Oszimilian/SBIO/(list of files, drawings)

Other design files:
Hardware/Hardware_Sensorplatine/Sensorplatine/Sensorplatine/Sensorplatine.dsn
