Oszimilian/SBIO/Hardware/Archiev/Hardware_Steuerplatine/Gerber/Gerber_Final/SBIO3_Final/SBIO3_003/SBIO3/SBIO3.kicad_pcb

## KiCad design Hardware/Archiev/Hardware_Steuerplatine/Gerber/Gerber_Final/SBIO3_Final/SBIO3_003/SBIO3/SBIO3.kicad_pcb (2021-06-11)

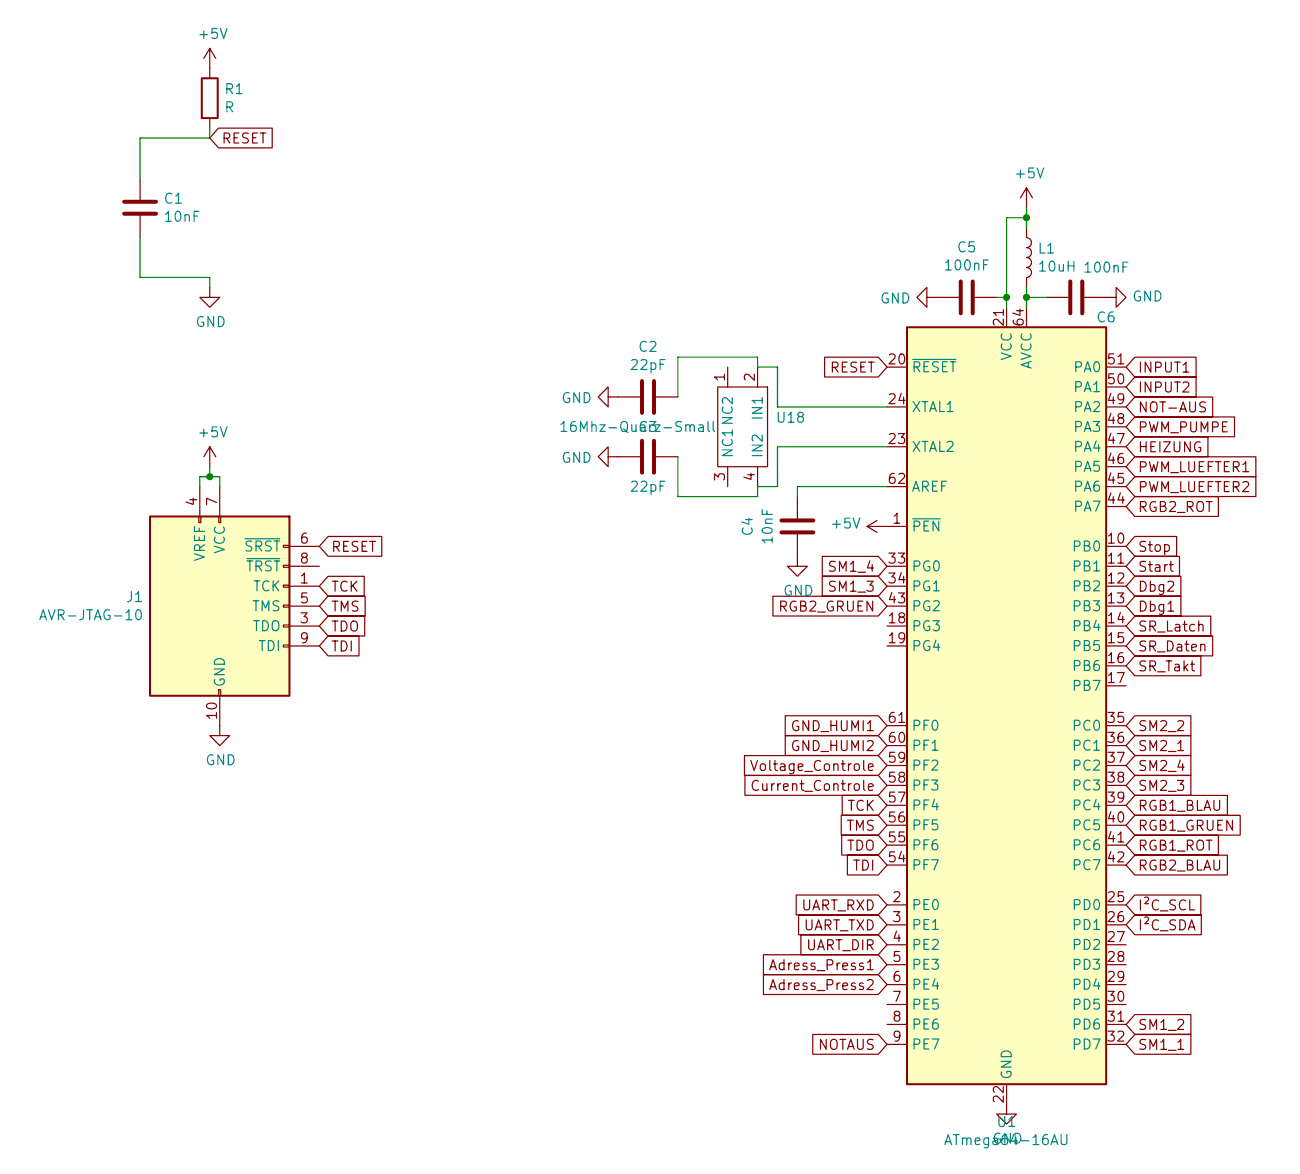
[picture p29: schematic file5EFE1688.sch]

Parts:
C1, C4: 10nF; C_0603_1608Metric_Pad1.05x0.95mm_HandSolder
C2, C3: 22pF; C_0603_1608Metric_Pad1.05x0.95mm_HandSolder
C5, C6: 100nF; C_0603_1608Metric_Pad1.05x0.95mm_HandSolder
J1: AVR-JTAG-10; Wanne-10Pol
L1: 10uH; L_0805_2012Metric_Pad1.15x1.40mm_HandSolder
R1: R; R_0603_1608Metric_Pad1.05x0.95mm_HandSolder
U1: ATmega64-16AU; TQFP-64_14x14mm_P0.8mm
U18: 16Mhz-Quarz-Small; 16Mhz Quarz Small

Connections:
+5V: C5.1, J1.4 (VREF), J1.7 (VCC), L1.1, R1.1, U1.1 (~PEN), U1.21 (VCC), U1.52 (VCC); also elsewhere on the board
Adress_Press1: U1.5 (PE3)
Adress_Press2: U1.6 (PE4); also elsewhere on the board
Current_Controle: U1.58 (PF3); also elsewhere on the board
Dbg1: U1.13 (PB3); also elsewhere on the board
Dbg2: U1.12 (PB2); also elsewhere on the board
GND: C1.2, C2.1, C3.1, C4.1, C5.2, C6.1, J1.2 (GND), J1.10 (GND), U1.22 (GND), U1.53 (GND), U1.63 (GND); also elsewhere on the board
GND_HUMI1: U1.61 (PF0); also elsewhere on the board
GND_HUMI2: U1.60 (PF1); also elsewhere on the board
HEIZUNG: U1.47 (PA4); also elsewhere on the board
INPUT1: U1.51 (PA0); also elsewhere on the board
INPUT2: U1.50 (PA1); also elsewhere on the board
I²C_SCL: U1.25 (PD0); also elsewhere on the board
I²C_SDA: U1.26 (PD1); also elsewhere on the board
NOT-AUS: U1.49 (PA2); also elsewhere on the board
NOTAUS: U1.9 (PE7); also elsewhere on the board
unnamed: C2.2, U1.24 (XTAL1), U18.2 (IN1)
unnamed: C3.2, U1.23 (XTAL2), U18.4 (IN2)
unnamed: C4.2, U1.62 (AREF)
unnamed: C6.2, L1.2, U1.64 (AVCC)
PWM_LUEFTER1: U1.46 (PA5); also elsewhere on the board
PWM_LUEFTER2: U1.45 (PA6); also elsewhere on the board
PWM_PUMPE: U1.48 (PA3); also elsewhere on the board
RESET: C1.1, J1.6 (~SRST), R1.2, U1.20 (~RESET); also elsewhere on the board
RGB1_BLAU: U1.39 (PC4); also elsewhere on the board
RGB1_GRUEN: U1.40 (PC5); also elsewhere on the board
RGB1_ROT: U1.41 (PC6); also elsewhere on the board
RGB2_BLAU: U1.42 (PC7); also elsewhere on the board
RGB2_GRUEN: U1.43 (PG2); also elsewhere on the board
RGB2_ROT: U1.44 (PA7); also elsewhere on the board
SM1_1: U1.32 (PD7); also elsewhere on the board
SM1_2: U1.31 (PD6); also elsewhere on the board
SM1_3: U1.34 (PG1); also elsewhere on the board
SM1_4: U1.33 (PG0); also elsewhere on the board
SM2_1: U1.36 (PC1); also elsewhere on the board
SM2_2: U1.35 (PC0); also elsewhere on the board
SM2_3: U1.38 (PC3); also elsewhere on the board
SM2_4: U1.37 (PC2); also elsewhere on the board
SR_Daten: U1.15 (PB5); also elsewhere on the board
SR_Latch: U1.14 (PB4); also elsewhere on the board
SR_Takt: U1.16 (PB6); also elsewhere on the board
Start: U1.11 (PB1); also elsewhere on the board
Stop: U1.10 (PB0); also elsewhere on the board
TCK: J1.1 (TCK), U1.57 (PF4)
TDI: J1.9 (TDI), U1.54 (PF7)
TDO: J1.3 (TDO), U1.55 (PF6)
TMS: J1.5 (TMS), U1.56 (PF5)
UART_DIR: U1.4 (PE2); also elsewhere on the board
UART_RXD: U1.2 (PE0); also elsewhere on the board
UART_TXD: U1.3 (PE1); also elsewhere on the board
Voltage_Controle: U1.59 (PF2); also elsewhere on the board

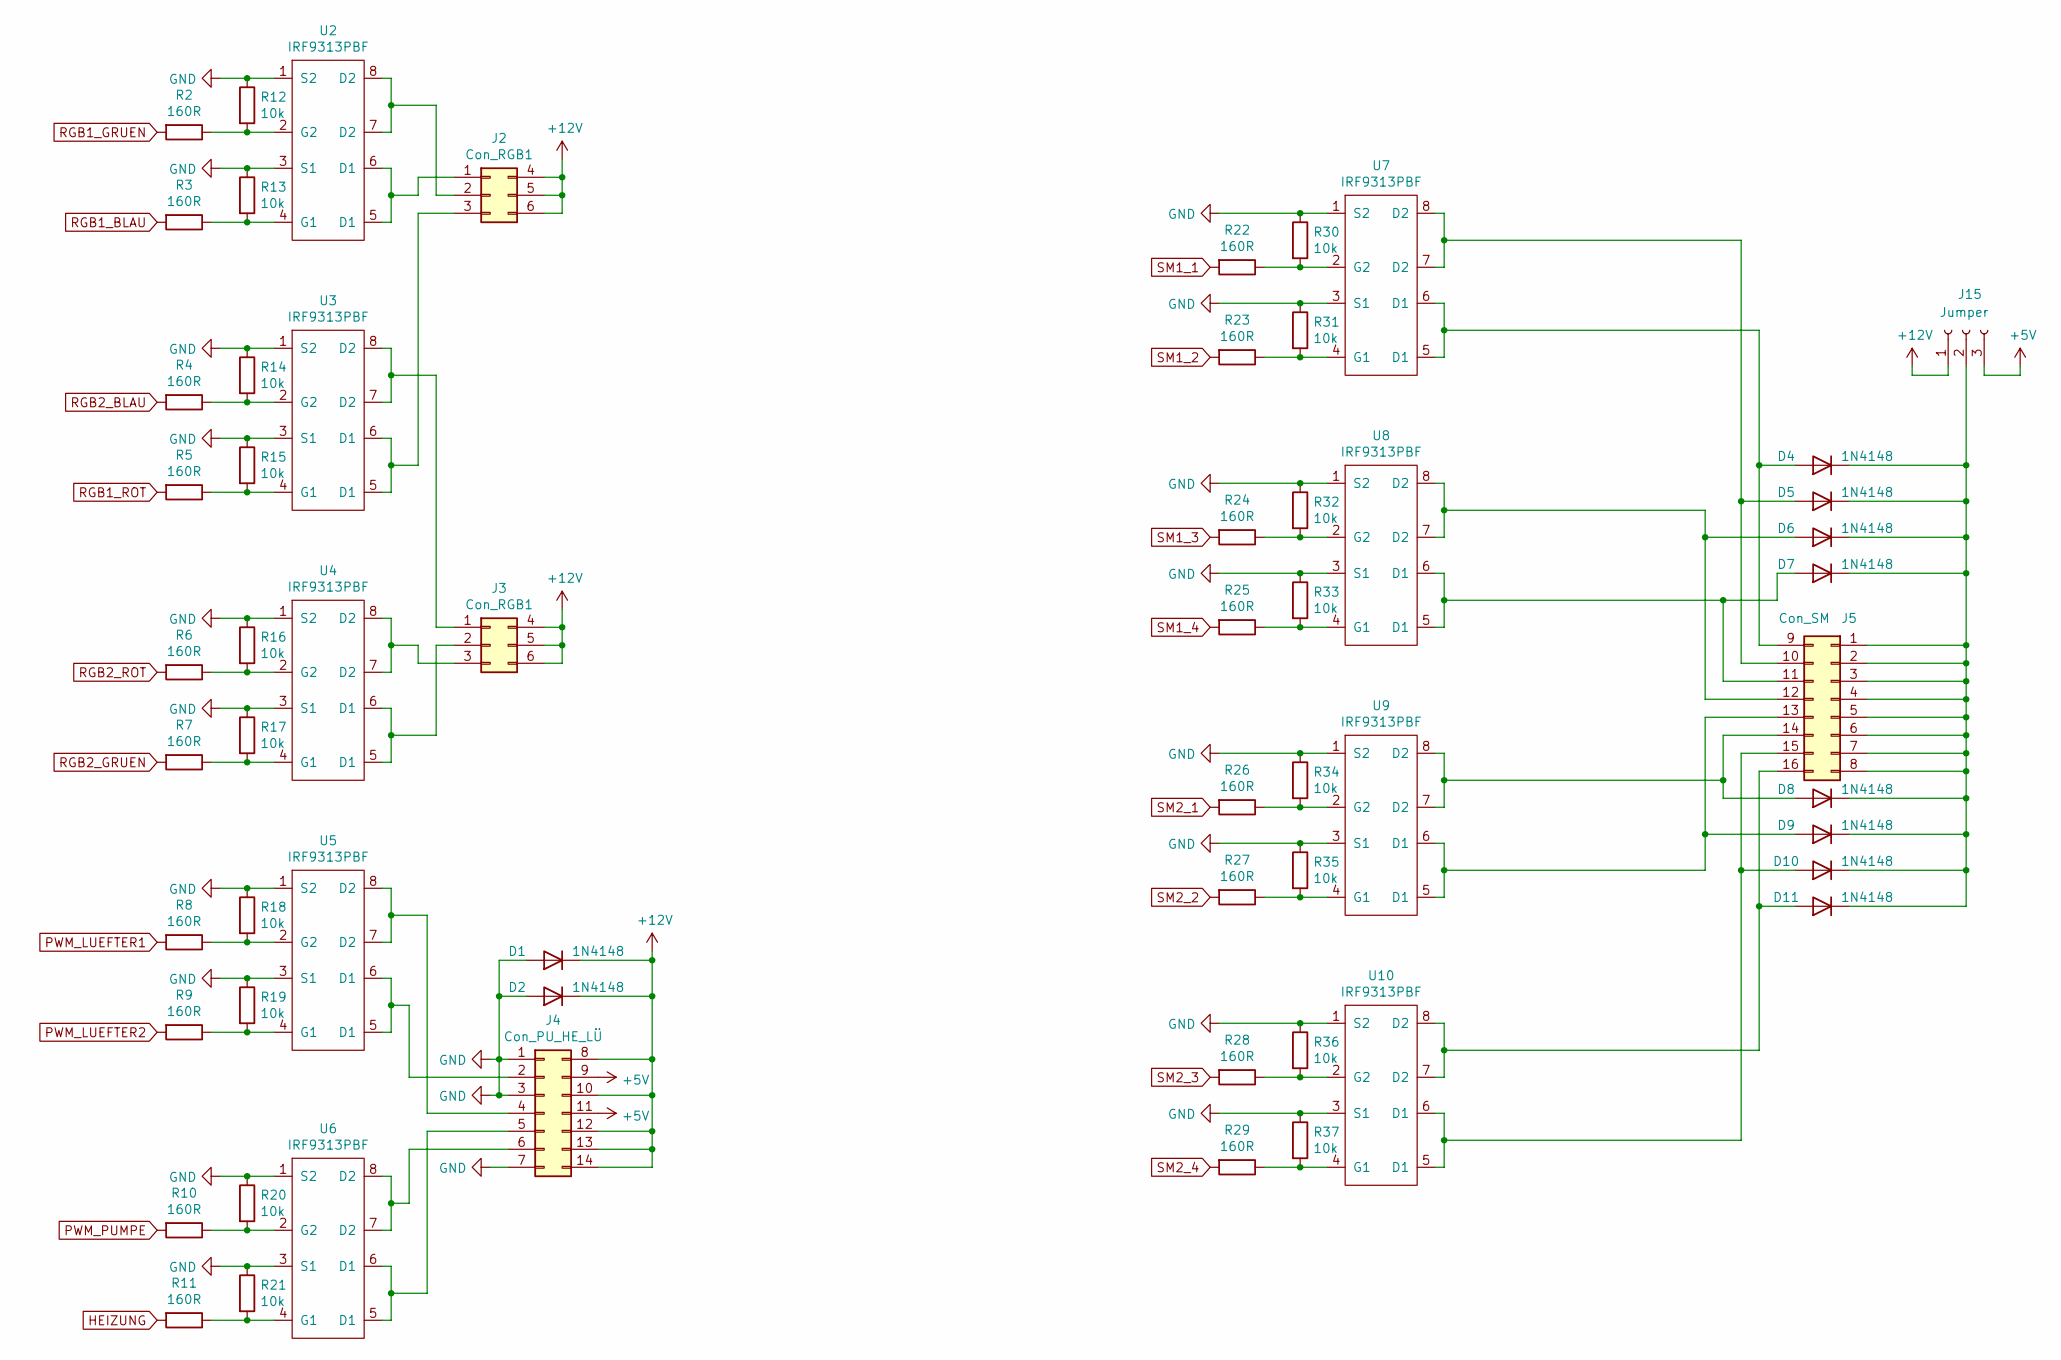
[picture p30: schematic file5F00A1EB.sch]

Parts:
D1, D2, D4, D5, D6, D7, D8, D9, D10, D11: 1N4148; D_SOD-323_HandSoldering
J2, J3: Con_RGB1; Wanne_6Pol
J4: Con_PU_HE_LÜ; Wanne-14Pol
J5: Con_SM; Wanne_16Pol
J15: Jumper; PinHeader_1x03_P2.54mm_Vertical
R2, R3, R4, R5, R6, R7, R8, R9, R10, R11, R22, R23, R24, R25, R26, R27, R28, R29: 160R; R_0603_1608Metric_Pad1.05x0.95mm_HandSolder
R12, R13, R14, R15, R16, R17, R18, R19, R20, R21, R30, R31, R32, R33, R34, R35, R36, R37: 10k; R_0603_1608Metric_Pad1.05x0.95mm_HandSolder
U2, U3, U4, U5, U6, U7, U8, U9, U10: IRF9313PBF; SO-8_3.9x4.9mm_P1.27mm

Connections:
+5V: J4.9, J4.11, J15.3; also elsewhere on the board
+12V: D1.1 (K), D2.1 (K), J2.4, J2.5, J2.6, J3.4, J3.5, J3.6, J4.8, J4.10, J4.12, J4.13, J4.14, J15.1; also elsewhere on the board
GND: D1.2 (A), D2.2 (A), J4.1, J4.3, J4.7, R12.1, R13.1, R14.1, R15.1, R16.1, R17.1, R18.1, R19.1, R20.1, R21.1, R30.1, R31.1, R32.1, R33.1, R34.1, R35.1, R36.1, R37.1, U2.1 (S2), U2.3 (S1), U3.1 (S2), U3.3 (S1), U4.1 (S2), U4.3 (S1), U5.1 (S2), U5.3 (S1), U6.1 (S2), U6.3 (S1), U7.1 (S2), U7.3 (S1), U8.1 (S2), U8.3 (S1), U9.1 (S2), U9.3 (S1), U10.1 (S2), U10.3 (S1); also elsewhere on the board
HEIZUNG: R11.2; also elsewhere on the board
unnamed: D4.2 (A), J5.9, U7.5 (D1), U7.6 (D1)
unnamed: D5.2 (A), J5.10, U7.7 (D2), U7.8 (D2)
unnamed: D6.2 (A), J5.12, U8.7 (D2), U8.8 (D2)
unnamed: D7.2 (A), J5.11, U8.5 (D1), U8.6 (D1)
unnamed: D8.2 (A), J5.14, U9.7 (D2), U9.8 (D2)
unnamed: D9.2 (A), J5.13, U9.5 (D1), U9.6 (D1)
unnamed: D4.1 (K), D5.1 (K), D6.1 (K), D7.1 (K), D8.1 (K), D9.1 (K), D10.1 (K), D11.1 (K), J5.1, J5.2, J5.3, J5.4, J5.5, J5.6, J5.7, J5.8, J15.2
unnamed: D10.2 (A), J5.15, U10.5 (D1), U10.6 (D1)
unnamed: D11.2 (A), J5.16, U10.7 (D2), U10.8 (D2)
unnamed: J2.1, U2.5 (D1), U2.6 (D1)
unnamed: J2.2, U2.7 (D2), U2.8 (D2)
unnamed: J2.3, U3.5 (D1), U3.6 (D1)
unnamed: J3.1, U3.7 (D2), U3.8 (D2)
unnamed: J3.2, U4.5 (D1), U4.6 (D1)
unnamed: J3.3, U4.7 (D2), U4.8 (D2)
unnamed: J4.2, U5.5 (D1), U5.6 (D1)
unnamed: J4.4, U5.7 (D2), U5.8 (D2)
unnamed: J4.5, U6.5 (D1), U6.6 (D1)
unnamed: J4.6, U6.7 (D2), U6.8 (D2)
unnamed: R10.1, R20.2, U6.2 (G2)
unnamed: R11.1, R21.2, U6.4 (G1)
unnamed: R2.1, R12.2, U2.2 (G2)
unnamed: R3.1, R13.2, U2.4 (G1)
unnamed: R4.1, R14.2, U3.2 (G2)
unnamed: R5.1, R15.2, U3.4 (G1)
unnamed: R6.1, R16.2, U4.2 (G2)
unnamed: R7.1, R17.2, U4.4 (G1)
unnamed: R8.1, R18.2, U5.2 (G2)
unnamed: R9.1, R19.2, U5.4 (G1)
unnamed: R22.1, R30.2, U7.2 (G2)
unnamed: R23.1, R31.2, U7.4 (G1)
unnamed: R24.1, R32.2, U8.2 (G2)
unnamed: R25.1, R33.2, U8.4 (G1)
unnamed: R26.1, R34.2, U9.2 (G2)
unnamed: R27.1, R35.2, U9.4 (G1)
unnamed: R28.1, R36.2, U10.2 (G2)
unnamed: R29.1, R37.2, U10.4 (G1)
PWM_LUEFTER1: R8.2; also elsewhere on the board
PWM_LUEFTER2: R9.2; also elsewhere on the board
PWM_PUMPE: R10.2; also elsewhere on the board
RGB1_BLAU: R3.2; also elsewhere on the board
RGB1_GRUEN: R2.2; also elsewhere on the board
RGB1_ROT: R5.2; also elsewhere on the board
RGB2_BLAU: R4.2; also elsewhere on the board
RGB2_GRUEN: R7.2; also elsewhere on the board
RGB2_ROT: R6.2; also elsewhere on the board
SM1_1: R22.2; also elsewhere on the board
SM1_2: R23.2; also elsewhere on the board
SM1_3: R24.2; also elsewhere on the board
SM1_4: R25.2; also elsewhere on the board
SM2_1: R26.2; also elsewhere on the board
SM2_2: R27.2; also elsewhere on the board
SM2_3: R28.2; also elsewhere on the board
SM2_4: R29.2; also elsewhere on the board

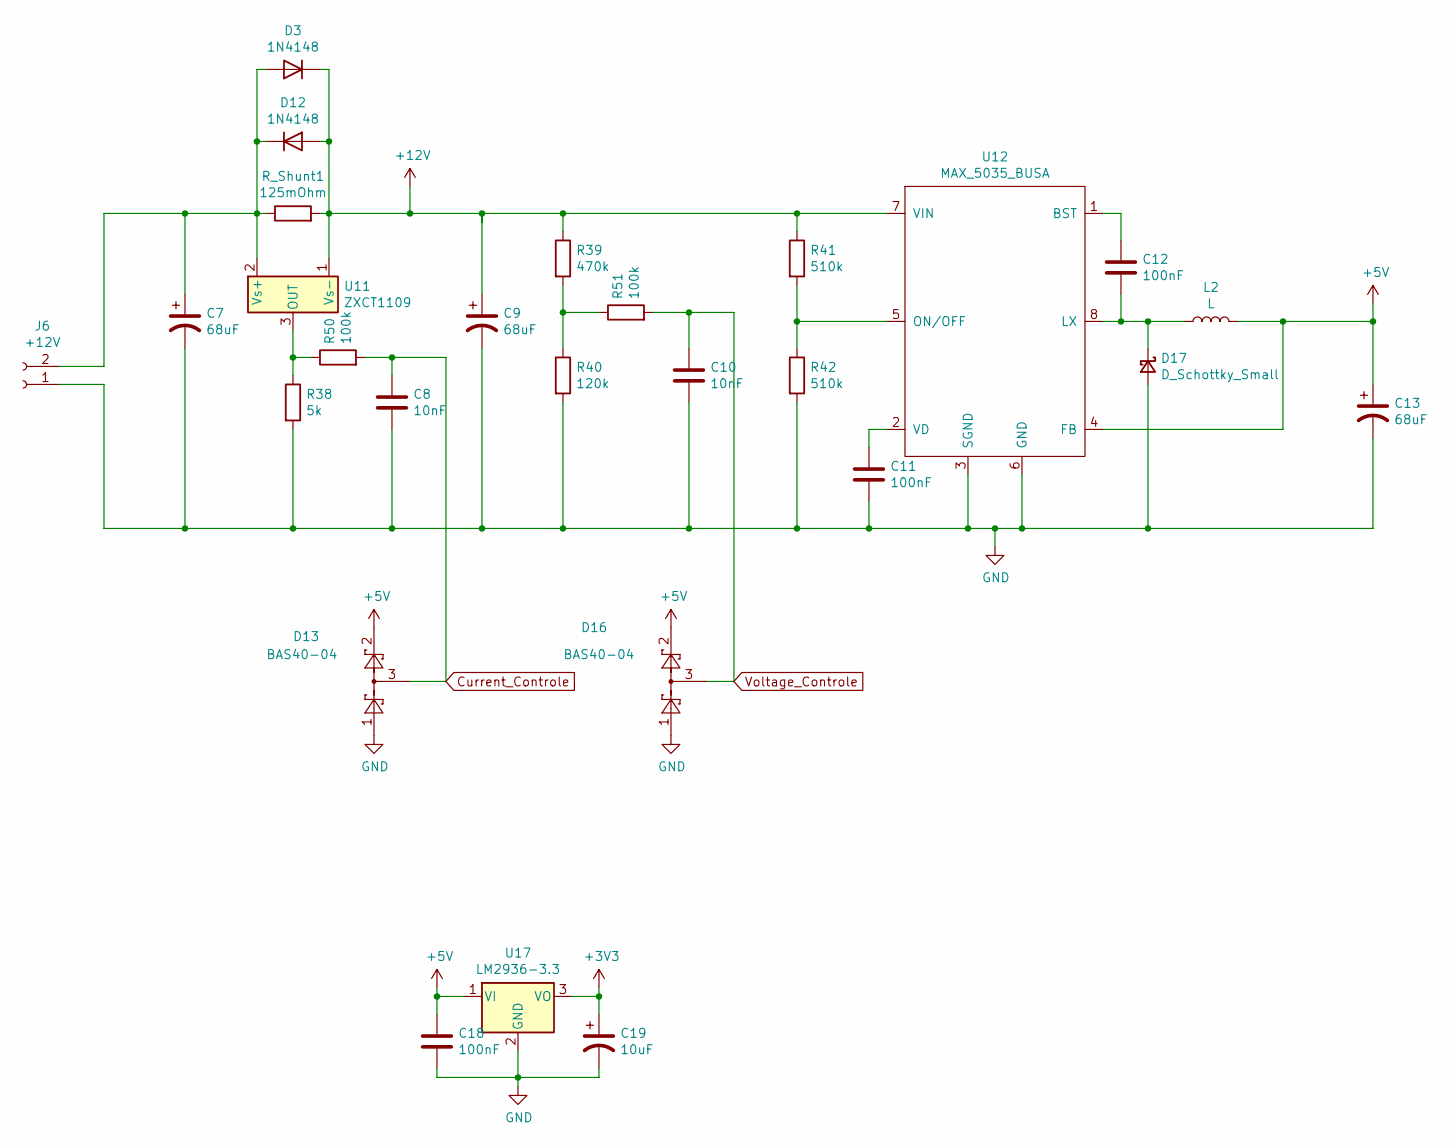
[picture p31: schematic file5F391D4F.sch]

Parts:
C7, C13: 68uF; C_2512_6332Metric
C8, C10: 10nF; C_0603_1608Metric_Pad1.05x0.95mm_HandSolder
C9: 68uF; C_2512_6332Metric_Pad1.52x3.35mm_HandSolder
C11, C12, C18: 100nF; C_0603_1608Metric_Pad1.05x0.95mm_HandSolder
C19: 10uF; C_1206_3216Metric
D3, D12: 1N4148
D13, D16: BAS40-04; SOT-23
D17: D_Schottky_Small; MAX5035_50SQ100
J6: +12V; PhoenixContact_MSTBA_2,5_2-G_1x02_P5.00mm_Horizontal
L2: L; MAX5035_100uH_Coil
R38: 5k; R_0603_1608Metric_Pad1.05x0.95mm_HandSolder
R39: 470k; R_0603_1608Metric_Pad1.05x0.95mm_HandSolder
R40: 120k; R_0603_1608Metric_Pad1.05x0.95mm_HandSolder
R41, R42: 510k; R_0603_1608Metric_Pad1.05x0.95mm_HandSolder
R50, R51: 100k; R_0603_1608Metric_Pad1.05x0.95mm_HandSolder
R_Shunt1: 125mOhm; R_2512_6332Metric_Pad1.52x3.35mm_HandSolder
U11: ZXCT1109; SOT-23
U12: MAX_5035_BUSA; SO-8_3.9x4.9mm_P1.27mm
U17: LM2936-3.3; SOT-223

Connections:
+3V3: C19.1, U17.3 (VO); also elsewhere on the board
+5V: C13.1, C18.1, D13.2, D16.2, L2.2, U12.4 (FB), U17.1 (VI); also elsewhere on the board
+12V: C9.1, D3.1 (K), D12.2 (A), R39.1, R41.1, R_Shunt1.2, U11.1 (Vs-), U12.7 (VIN); also elsewhere on the board
Current_Controle: C8.1, D13.3, R50.2; also elsewhere on the board
GND: C7.2, C8.2, C9.2, C10.2, C11.2, C13.2, C18.2, C19.2, D13.1, D16.1, D17.2 (A), J6.1, R38.2, R40.2, R42.2, U12.3 (SGND), U12.6 (GND), U17.2 (GND); also elsewhere on the board
unnamed: C7.1, D3.2 (A), D12.1 (K), J6.2, R_Shunt1.1, U11.2 (Vs+)
unnamed: C11.1, U12.2 (VD)
unnamed: C12.1, U12.1 (BST)
unnamed: C12.2, D17.1 (K), L2.1, U12.8 (LX)
unnamed: R38.1, R50.1, U11.3 (OUT)
unnamed: R39.2, R40.1, R51.1
unnamed: R41.2, R42.1, U12.5 (ON/OFF)
Voltage_Controle: C10.1, D16.3, R51.2; also elsewhere on the board

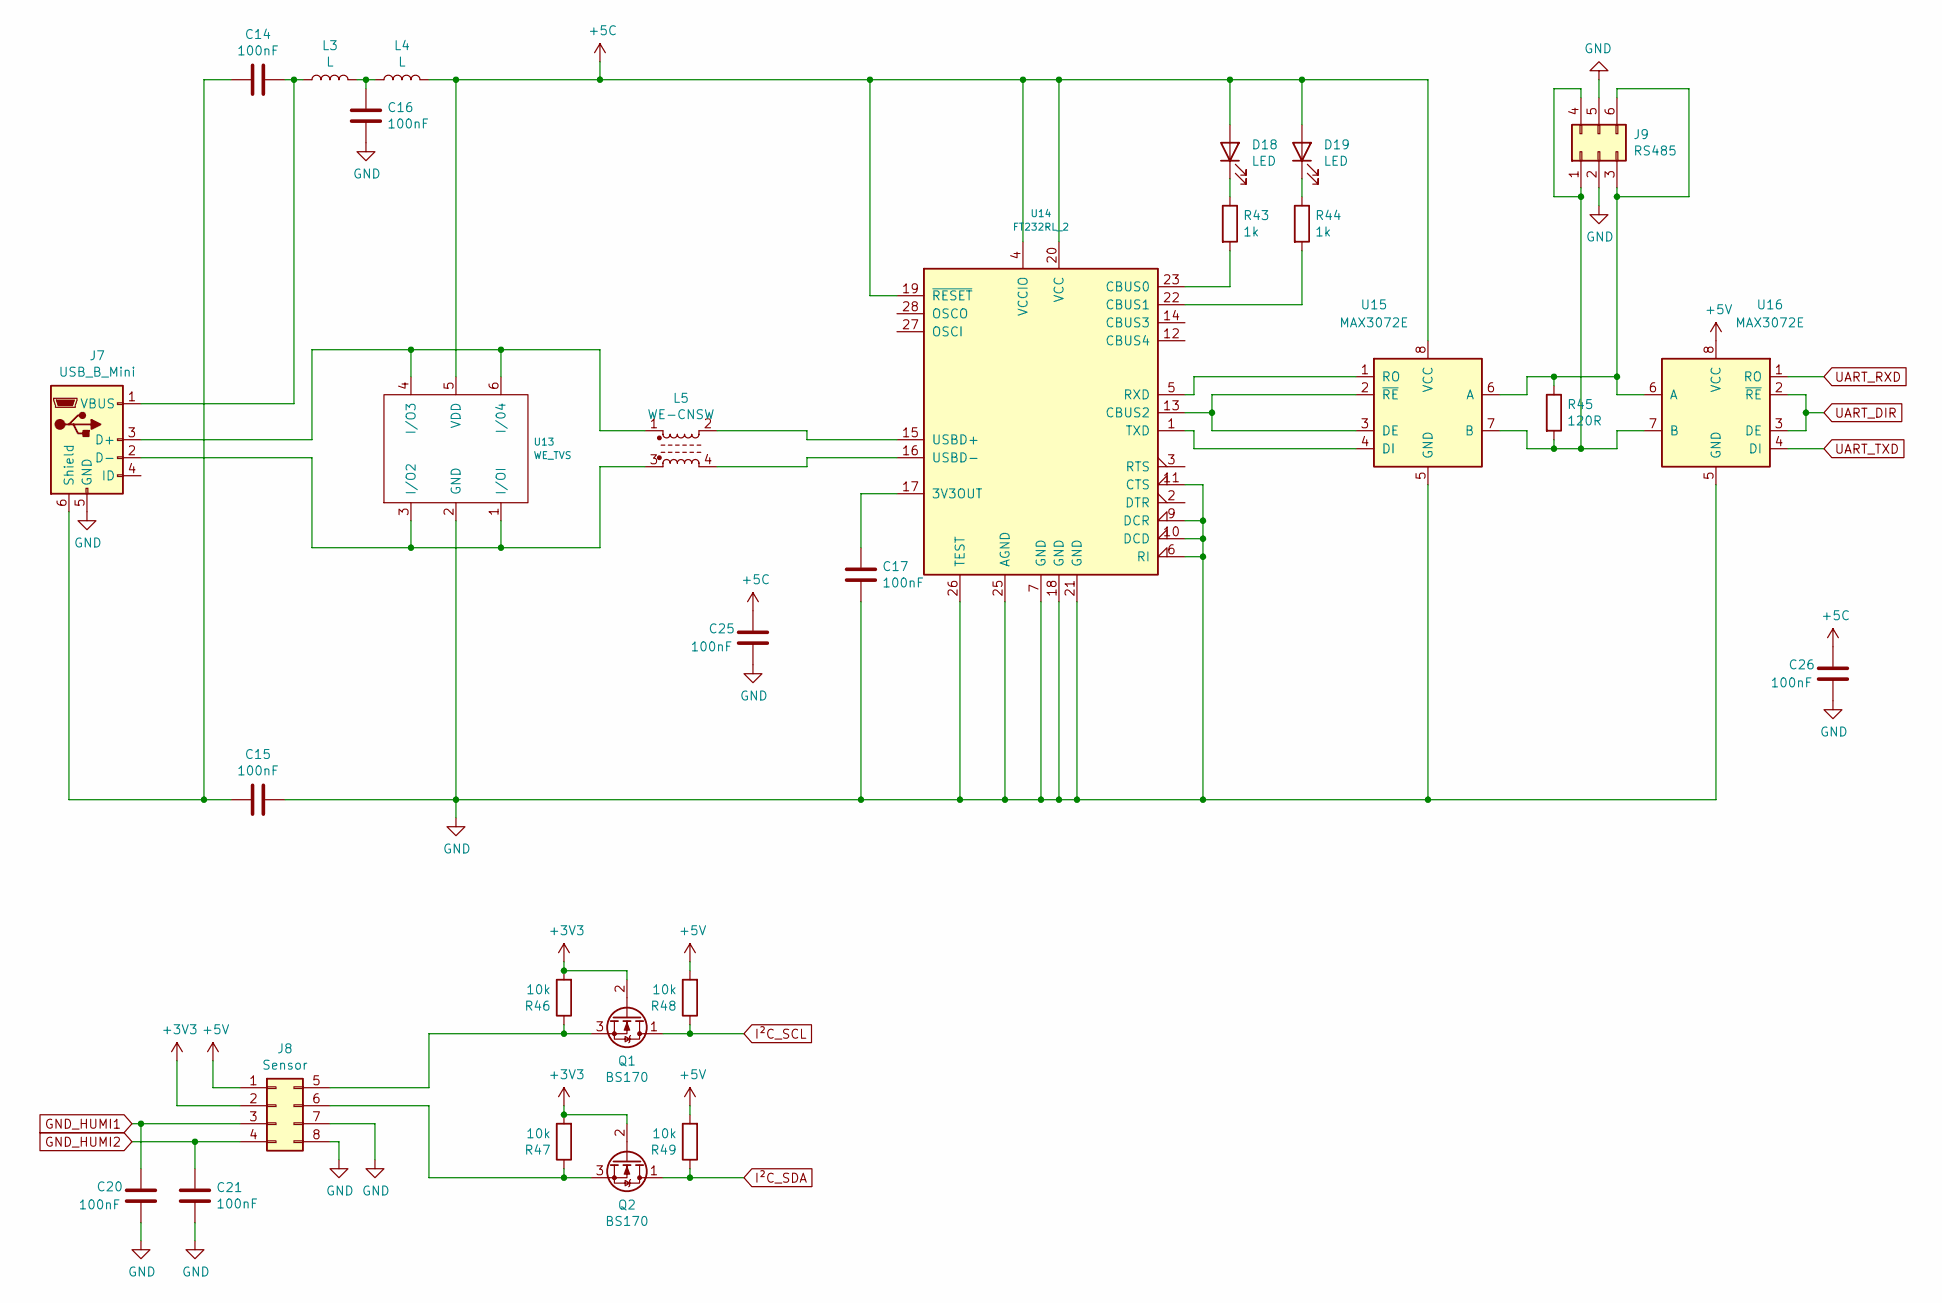
[picture p32: schematic file5F459810.sch]

Parts:
C14, C15, C16, C17, C20, C21, C25, C26: 100nF; C_0603_1608Metric_Pad1.05x0.95mm_HandSolder
D18, D19: LED; LED_0805_2012Metric_Pad1.15x1.40mm_HandSolder
J7: USB_B_Mini; USB_Mini-B_Lumberg_2486_01_Horizontal
J8: Sensor; Wanne-8Pol
J9: RS485; Wanne_6Pol
L3, L4: L; L_0603_1608Metric_Pad1.05x0.95mm_HandSolder
L5: WE-CNSW
Q1, Q2: BS170; SOT-323_SC-70
R43, R44: 1k; R_0603_1608Metric_Pad1.05x0.95mm_HandSolder
R45: 120R; R_0603_1608Metric_Pad1.05x0.95mm_HandSolder
R46, R47, R48, R49: 10k; R_0603_1608Metric_Pad1.05x0.95mm_HandSolder
U13: WE_TVS; SOT-23-6_Handsoldering
U14: FT232RL_2; SSOP-28_5.3x10.2mm_P0.65mm
U15, U16: MAX3072E; SOIC-8_3.9x4.9mm_P1.27mm

Connections:
+3V3: J8.2, Q1.2 (G), Q2.2 (G), R46.2, R47.2; also elsewhere on the board
+5C: C25.2, C26.2, D18.2 (A), D19.2 (A), L4.2, U13.5 (VDD), U14.4 (VCCIO), U14.19 (~RESET~), U14.20 (VCC), U15.8 (VCC)
+5V: J8.1, R48.2, R49.2, U16.8 (VCC); also elsewhere on the board
GND: C15.1, C16.1, C17.1, C20.1, C21.1, C25.1, C26.1, J7.5 (GND), J8.7, J8.8, J9.2, J9.5, U13.2 (GND), U14.6 (RI), U14.7 (GND), U14.9 (DCR), U14.10 (DCD), U14.11 (CTS), U14.18 (GND), U14.21 (GND), U14.25 (AGND), U14.26 (TEST), U15.5 (GND), U16.5 (GND); also elsewhere on the board
GND_HUMI1: C20.2, J8.3; also elsewhere on the board
GND_HUMI2: C21.2, J8.4; also elsewhere on the board
I²C_SCL: Q1.1 (D), R48.1; also elsewhere on the board
I²C_SDA: Q2.1 (D), R49.1; also elsewhere on the board
unnamed: C14.1, J7.1 (VBUS), L3.1
unnamed: C14.2, C15.2, J7.6 (Shield)
unnamed: C16.2, L3.2, L4.1
unnamed: C17.2, U14.17 (3V3OUT)
unnamed: D18.1 (K), R43.1
unnamed: D19.1 (K), R44.1
unnamed: J7.2 (D-), L5.3, U13.1 (I/OI), U13.3 (I/O2)
unnamed: J7.3 (D+), L5.1, U13.4 (I/O3), U13.6 (I/04)
unnamed: J8.5, Q1.3 (S), R46.1
unnamed: J8.6, Q2.3 (S), R47.1
unnamed: J9.1, J9.4, R45.2, U15.7 (B), U16.7 (B)
unnamed: J9.3, J9.6, R45.1, U15.6 (A), U16.6 (A)
unnamed: L5.2, U14.15 (USBD+)
unnamed: L5.4, U14.16 (USBD-)
unnamed: R43.2, U14.23 (CBUS0)
unnamed: R44.2, U14.22 (CBUS1)
unnamed: U14.1 (TXD), U15.4 (DI)
unnamed: U14.5 (RXD), U15.1 (RO)
unnamed: U14.13 (CBUS2), U15.2 (~RE~), U15.3 (DE)
UART_DIR: U16.2 (~RE~), U16.3 (DE); also elsewhere on the board
UART_RXD: U16.1 (RO); also elsewhere on the board
UART_TXD: U16.4 (DI); also elsewhere on the board

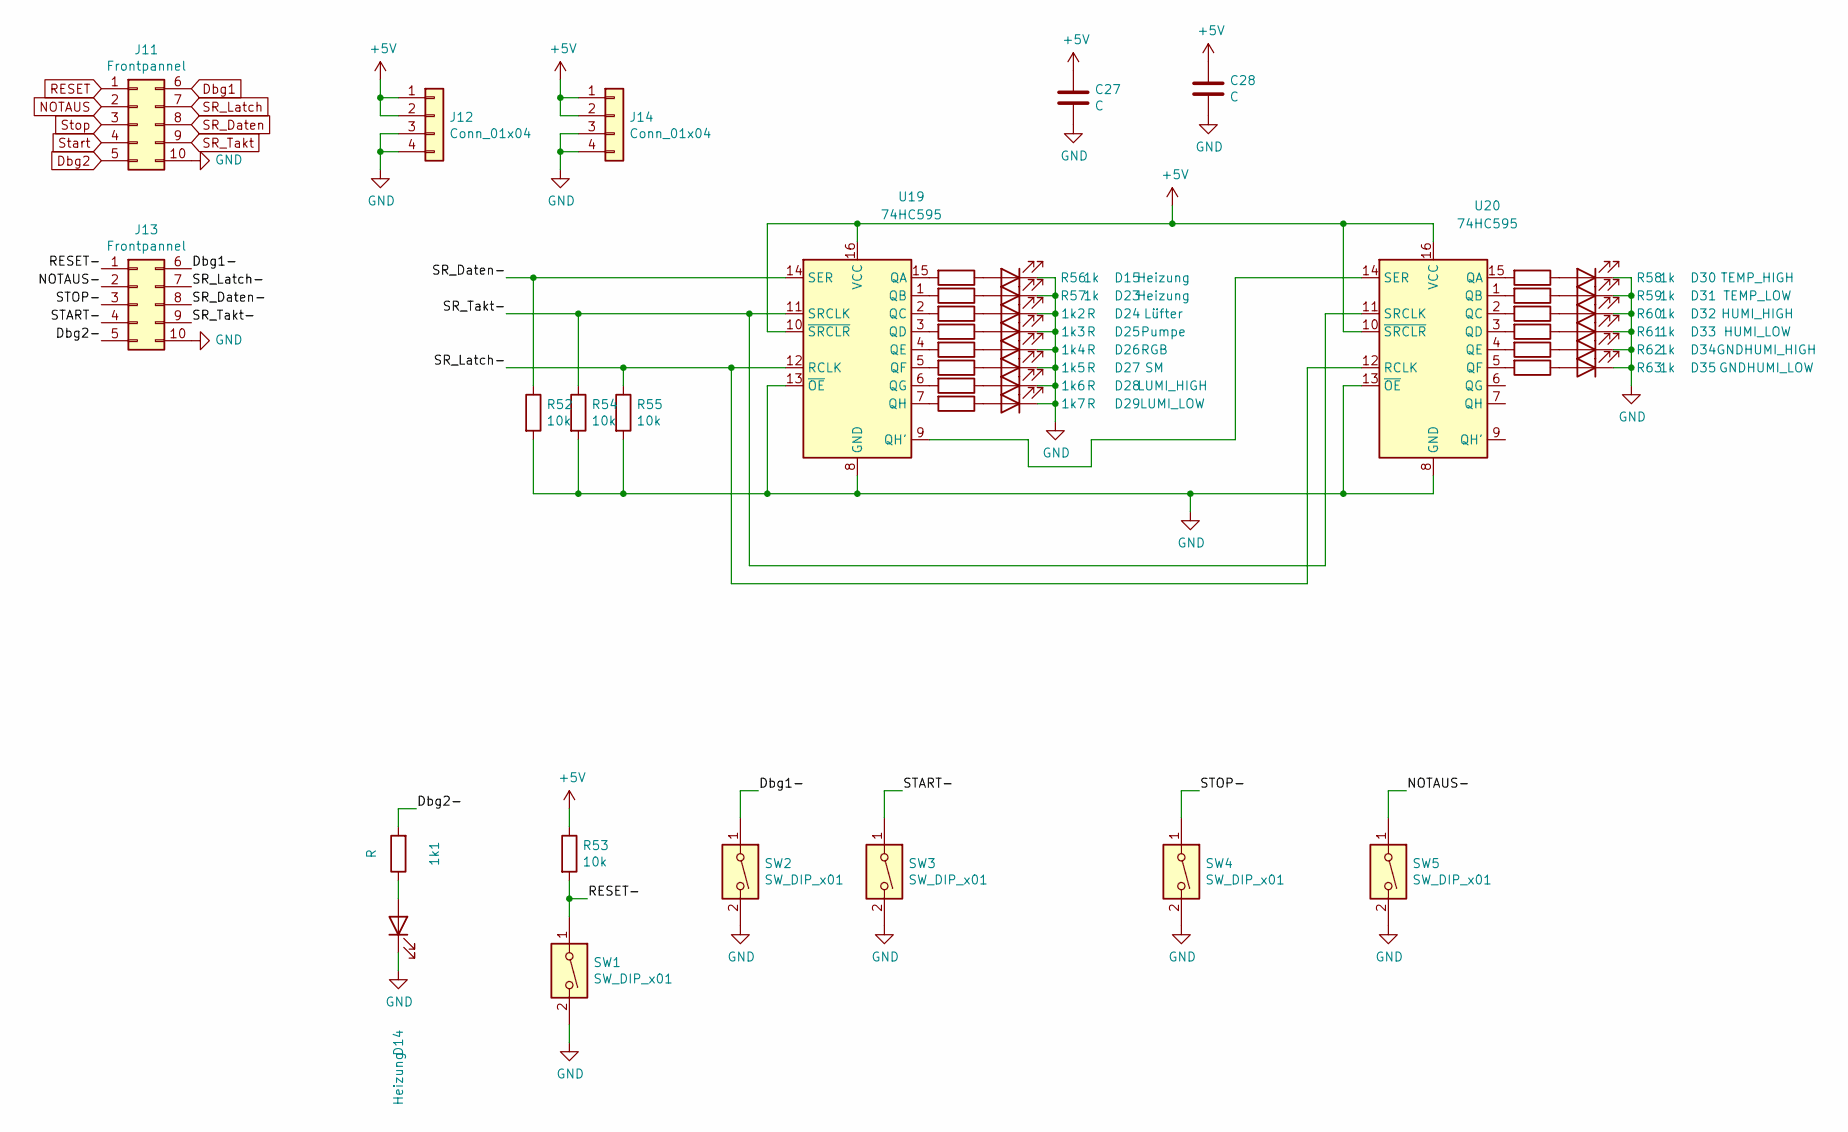
[picture p33: schematic file5F00A23E.sch]

Parts:
1k1, 1k2, 1k3, 1k4, 1k5, 1k6, 1k7: R; R_0603_HandSoldering
C27, C28: C; C_0603_1608Metric_Pad1.05x0.95mm_HandSolder
D14, D15, D23: Heizung; LED_D3.0mm
D24: Lüfter; LED_D3.0mm
D25: Pumpe; LED_D3.0mm
D26: RGB; LED_D3.0mm
D27: SM; LED_D3.0mm
D28: LUMI_HIGH; LED_D3.0mm
D29: LUMI_LOW; LED_D3.0mm
D30: TEMP_HIGH; LED_D3.0mm
D31: TEMP_LOW; LED_D3.0mm
D32: HUMI_HIGH; LED_D3.0mm
D33: HUMI_LOW; LED_D3.0mm
D34: GNDHUMI_HIGH; LED_D3.0mm
D35: GNDHUMI_LOW; LED_D3.0mm
J11, J13: Frontpannel; PinSocket_2x05_P2.54mm_Vertical
J12, J14: Conn_01x04; PinSocket_1x04_P2.54mm_Vertical
R52, R53, R54, R55: 10k; R_0603_HandSoldering
R56, R57, R58, R59, R60, R61, R62, R63: 1k; R_0603_HandSoldering
SW1: SW_DIP_x01; SW_PUSH_6mm_h4.3mm
SW2, SW3, SW4, SW5: SW_DIP_x01; SW_PUSH_6mm
U19, U20: 74HC595; SOIC-16_3.9x9.9mm_Pitch1.27mm

Connections:
+5V: C27.1, C28.1, J12.1, J12.2, J14.1, J14.2, R53.1, U19.10 (~SRCLR), U19.16 (VCC), U20.10 (~SRCLR), U20.16 (VCC); also elsewhere on the board
/Frontpannel/Dbg1-: J13.6, SW2.1
/Frontpannel/Dbg2-: 1k1.2, J13.5
/Frontpannel/NOTAUS-: J13.2, SW5.1
/Frontpannel/RESET-: J13.1, R53.2, SW1.1
/Frontpannel/SR_Daten-: J13.8, R52.1, U19.14 (SER)
/Frontpannel/SR_Latch-: J13.7, R55.1, U19.12 (RCLK), U20.12 (RCLK)
/Frontpannel/SR_Takt-: J13.9, R54.1, U19.11 (SRCLK), U20.11 (SRCLK)
/Frontpannel/START-: J13.4, SW3.1
/Frontpannel/STOP-: J13.3, SW4.1
Dbg1: J11.6; also elsewhere on the board
Dbg2: J11.5; also elsewhere on the board
GND: C27.2, C28.2, D14.1 (K), D15.1 (K), D23.1 (K), D24.1 (K), D25.1 (K), D26.1 (K), D27.1 (K), D28.1 (K), D29.1 (K), D30.1 (K), D31.1 (K), D32.1 (K), D33.1 (K), D34.1 (K), D35.1 (K), J11.10, J12.3, J12.4, J13.10, J14.3, J14.4, R52.2, R54.2, R55.2, SW1.2, SW2.2, SW3.2, SW4.2, SW5.2, U19.8 (GND), U19.13 (~OE), U20.8 (GND), U20.13 (~OE); also elsewhere on the board
NOTAUS: J11.2; also elsewhere on the board
unnamed: 1k1.1, D14.2 (A)
unnamed: 1k2.1, D24.2 (A)
unnamed: 1k2.2, U19.2 (QC)
unnamed: 1k3.1, D25.2 (A)
unnamed: 1k3.2, U19.3 (QD)
unnamed: 1k4.1, D26.2 (A)
unnamed: 1k4.2, U19.4 (QE)
unnamed: 1k5.1, D27.2 (A)
unnamed: 1k5.2, U19.5 (QF)
unnamed: 1k6.1, D28.2 (A)
unnamed: 1k6.2, U19.6 (QG)
unnamed: 1k7.1, D29.2 (A)
unnamed: 1k7.2, U19.7 (QH)
unnamed: D15.2 (A), R56.1
unnamed: D23.2 (A), R57.1
unnamed: D30.2 (A), R58.1
unnamed: D31.2 (A), R59.1
unnamed: D32.2 (A), R60.1
unnamed: D33.2 (A), R61.1
unnamed: D34.2 (A), R62.1
unnamed: D35.2 (A), R63.1
unnamed: R56.2, U19.15 (QA)
unnamed: R57.2, U19.1 (QB)
unnamed: R58.2, U20.15 (QA)
unnamed: R59.2, U20.1 (QB)
unnamed: R60.2, U20.2 (QC)
unnamed: R61.2, U20.3 (QD)
unnamed: R62.2, U20.4 (QE)
unnamed: R63.2, U20.5 (QF)
unnamed: U19.9 (QH'), U20.14 (SER)
RESET: J11.1; also elsewhere on the board
SR_Daten: J11.8; also elsewhere on the board
SR_Latch: J11.7; also elsewhere on the board
SR_Takt: J11.9; also elsewhere on the board
Start: J11.4; also elsewhere on the board
Stop: J11.3; also elsewhere on the board

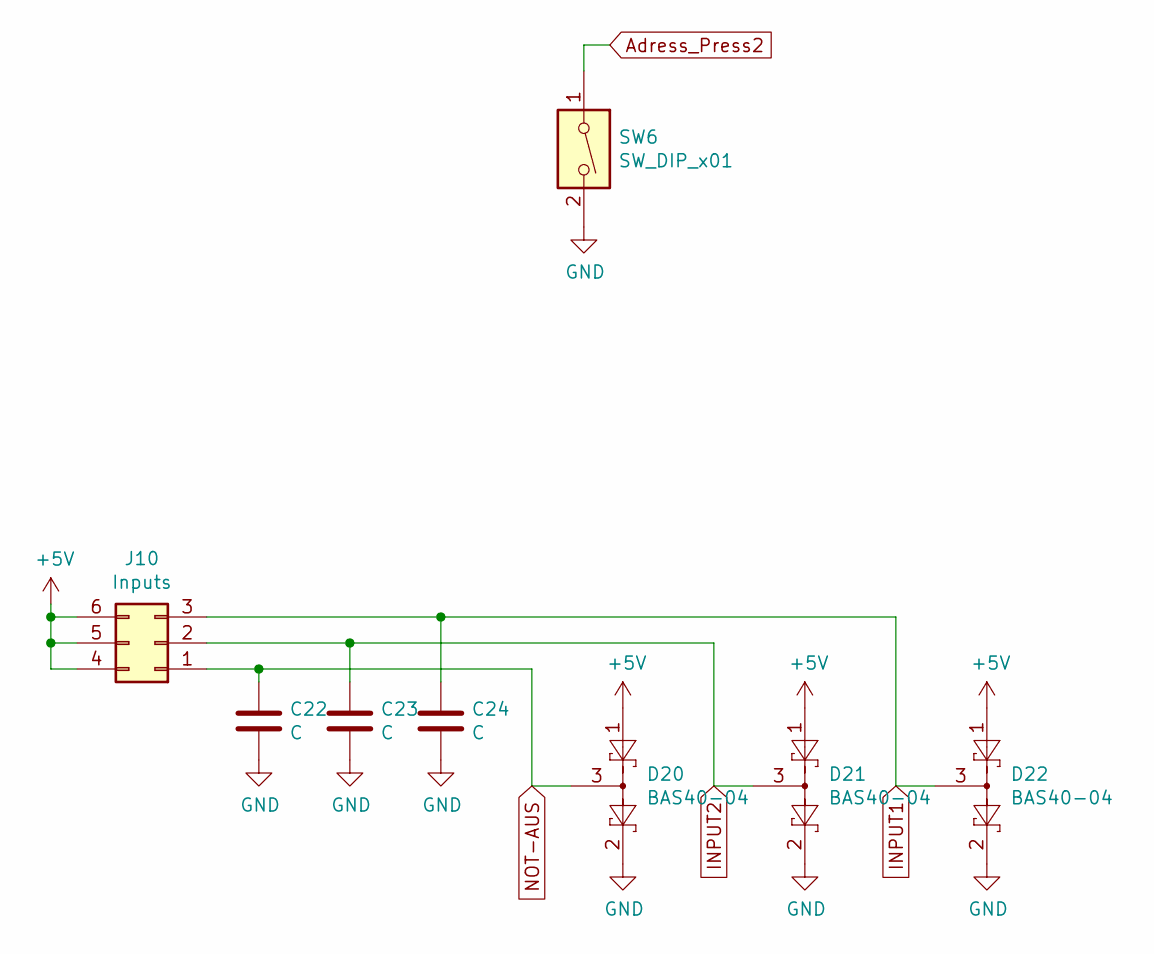
[picture p34: schematic file5F00A354.sch]

Parts:
C22, C23, C24: C; C_0603_1608Metric_Pad1.05x0.95mm_HandSolder
D20, D21, D22: BAS40-04; SOT-23
J10: Inputs; Wanne_6Pol
SW6: SW_DIP_x01; SW_Tactile_SPST_Angled_PTS645Vx31-2LFS

Connections:
+5V: D20.1, D21.1, D22.1, J10.4, J10.5, J10.6; also elsewhere on the board
Adress_Press2: SW6.1; also elsewhere on the board
GND: C22.2, C23.2, C24.2, D20.2, D21.2, D22.2, SW6.2; also elsewhere on the board
INPUT1: C24.1, D22.3, J10.3; also elsewhere on the board
INPUT2: C23.1, D21.3, J10.2; also elsewhere on the board
NOT-AUS: C22.1, D20.3, J10.1; also elsewhere on the board

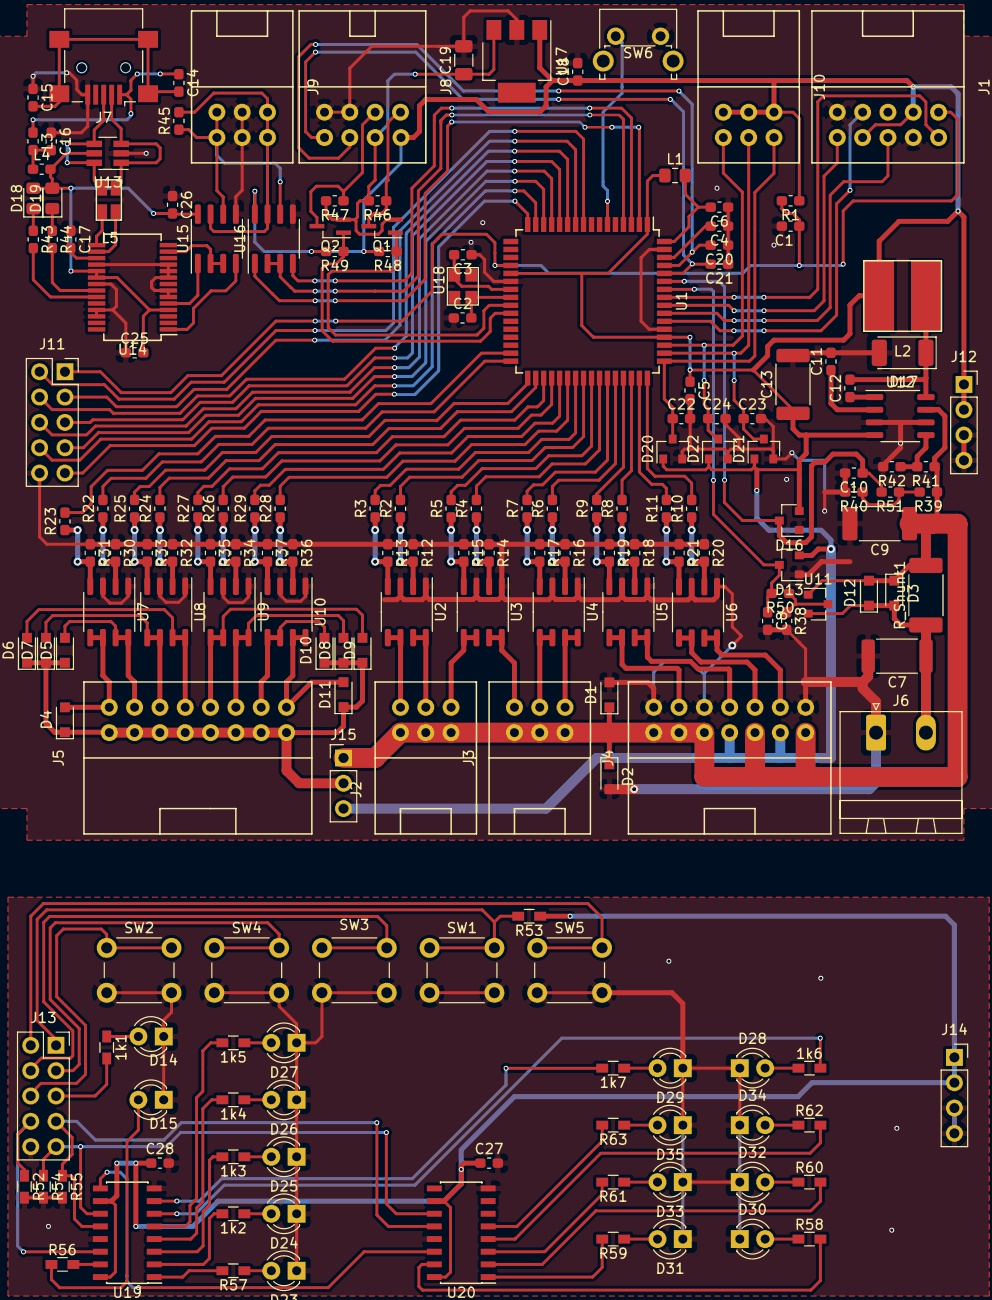
[picture p35: board SBIO3.kicad_pcb from above]

Board: 2 copper layers, 182 parts (0 on the bottom side), 155 nets.
