Oszimilian/SBIO/Hardware/Hardware_230V-Relais/230V-Relais_002/230V-Relais.kicad_pcb

## KiCad design Hardware/Hardware_230V-Relais/230V-Relais_002/230V-Relais.kicad_pcb (2021-06-11)

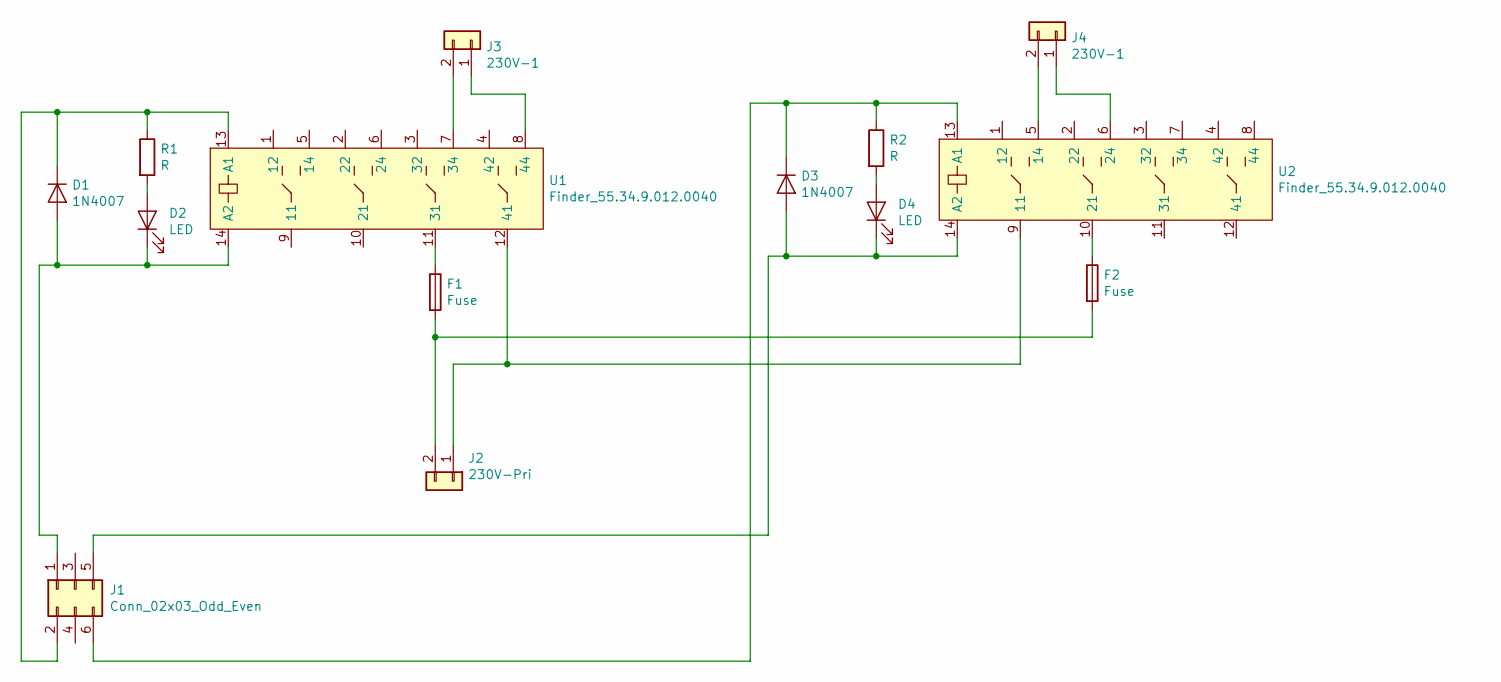
[picture p36: schematic 230V-Relais.sch]

Parts:
D1, D3: 1N4007; D_DO-41_SOD81_P10.16mm_Horizontal
D2, D4: LED; LED_D3.0mm
F1, F2: Fuse; Fuseholder_Cylinder-5x20mm_Schurter_0031_8201_Horizontal_Op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
J1: Conn_02x03_Odd_Even; Wanne_6Pol
J2: 230V-Pri; PhoenixContact_MSTBA_2,5_2-G-5,08_1x02_P5.08mm_Horizontal
J3, J4: 230V-1; PhoenixContact_MSTBA_2,5_2-G-5,08_1x02_P5.08mm_Horizontal
R1, R2: R; R_0805_2012Metric_Pad1.15x1.40mm_HandSolder
U1, U2: Finder_55.34.9.012.0040; Finder-55.34.012.0040

Connections:
unnamed: D1.1 (K), J1.2, R1.1, U1.13 (A1)
unnamed: D1.2 (A), D2.1 (K), J1.1, U1.14 (A2)
unnamed: D2.2 (A), R1.2
unnamed: D3.1 (K), J1.6, R2.1, U2.13 (A1)
unnamed: D3.2 (A), D4.1 (K), J1.5, U2.14 (A2)
unnamed: D4.2 (A), R2.2
unnamed: F1.1, U1.11 (31)
unnamed: F1.2, F2.2, J2.2
unnamed: F2.1, U2.10 (21)
unnamed: J2.1, U1.12 (41), U2.9 (11)
unnamed: J3.1, U1.8 (44)
unnamed: J3.2, U1.7 (34)
unnamed: J4.1, U2.6 (24)
unnamed: J4.2, U2.5 (14)

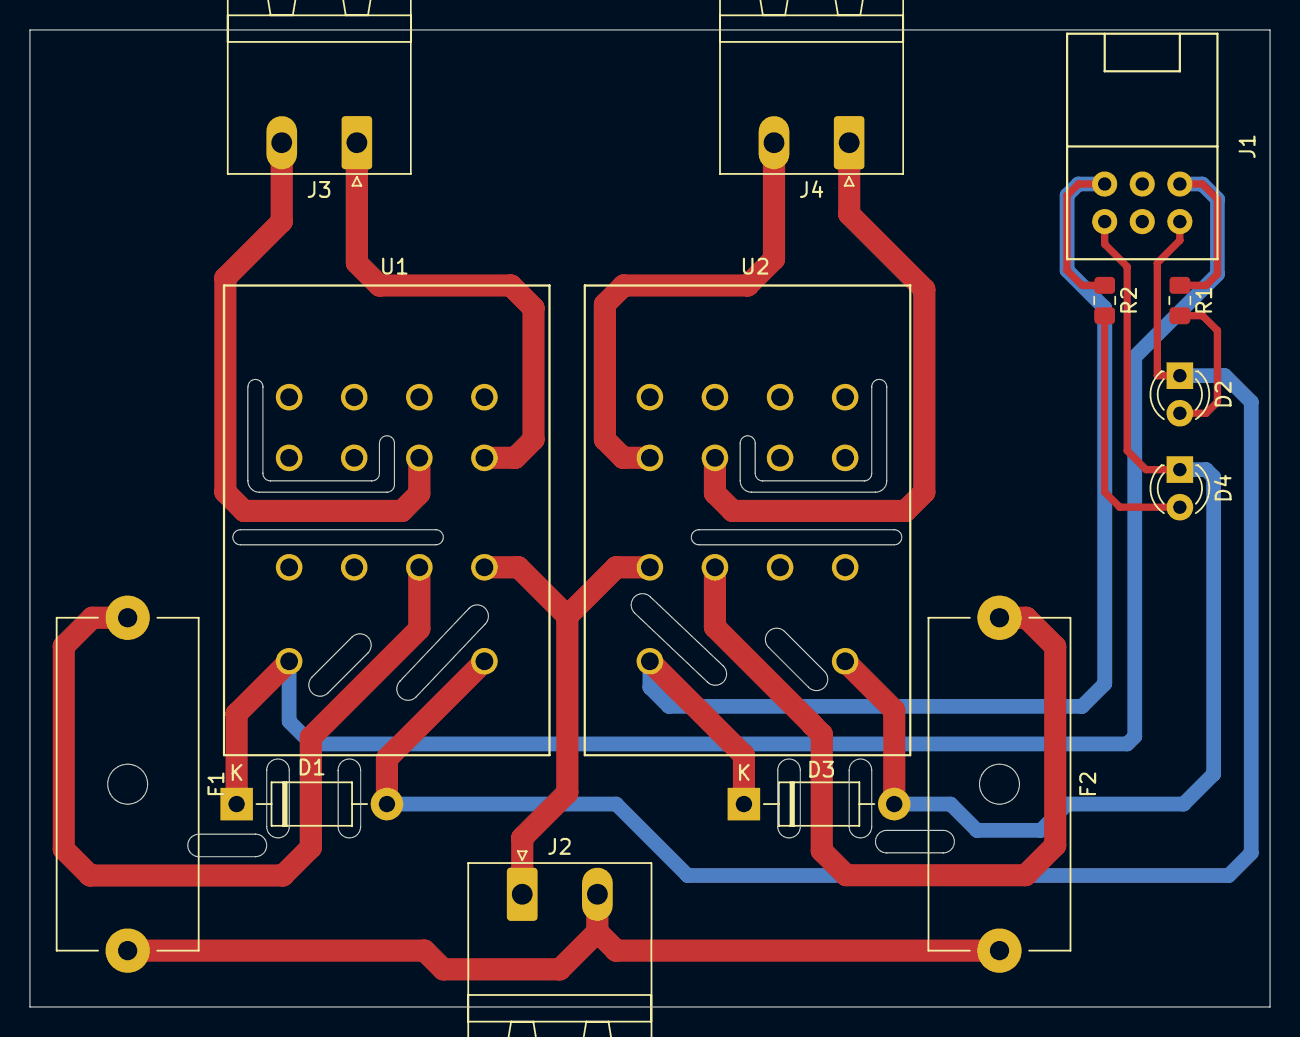
[picture p37: board 230V-Relais.kicad_pcb from above]

Board: 2 copper layers, 83.8 x 66.0 mm, 14 parts (0 on the bottom side), 14 nets.
