Oszimilian/SBIO/Hardware/Hardware_Sensorplatine/Sensorplatine/Sensorplatine/Sensorplatine.kicad_pcb

## KiCad design Hardware/Hardware_Sensorplatine/Sensorplatine/Sensorplatine/Sensorplatine.kicad_pcb (2021-06-11)

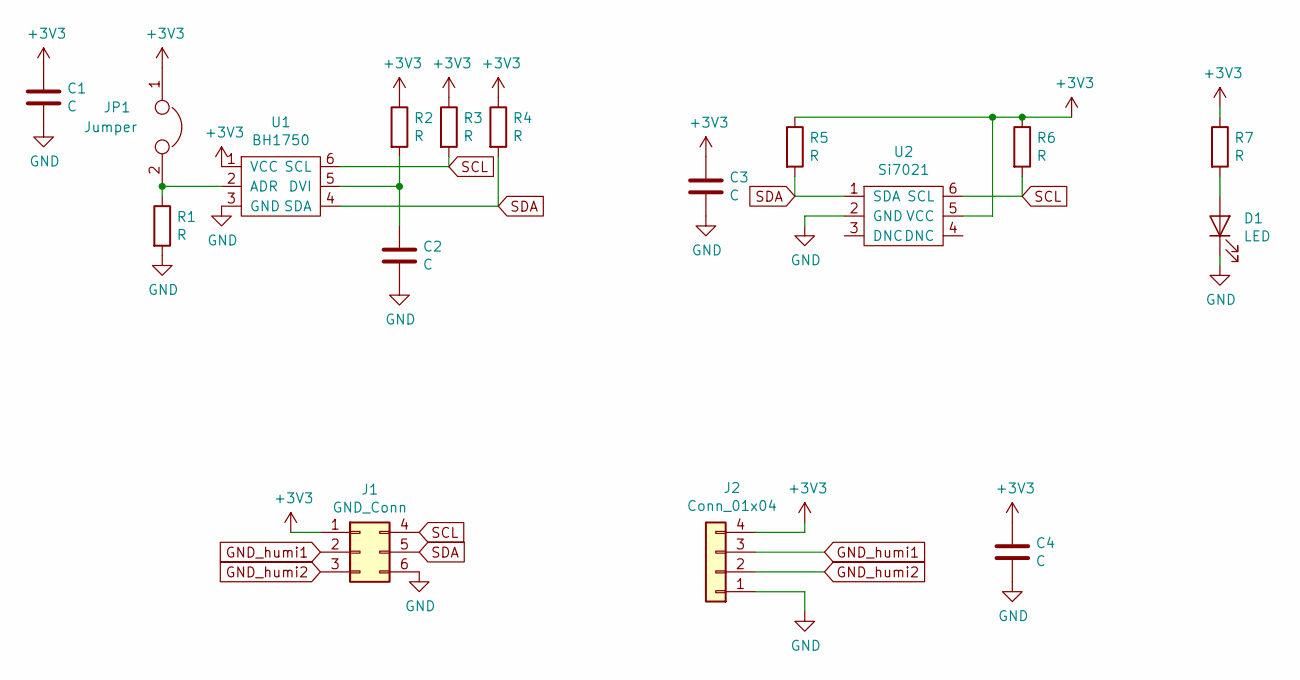
[picture p38: schematic Sensorplatine.sch]

Parts:
C1, C2, C3, C4: C; C_0603_1608Metric_Pad1.05x0.95mm_HandSolder
D1: LED; LED_0805_2012Metric_Pad1.15x1.40mm_HandSolder
J1: GND_Conn; PinSocket_2x03_P2.54mm_Vertical
J2: Conn_01x04; PinHeader_1x04_P2.54mm_Vertical
JP1: Jumper; SolderJumper-2_P1.3mm_Open_RoundedPad1.0x1.5mm
R1, R2, R3, R4, R5, R6, R7: R; R_0603_1608Metric_Pad1.05x0.95mm_HandSolder
U1: BH1750; Si7015
U2: Si7021; DFN-6-1EP_3x3mm_P1mm_EP1.5x2.4mm

Connections:
+3V3: C1.1, C3.1, C4.1, J1.1, J2.4, JP1.1, R2.1, R3.1, R4.1, R5.1, R6.1, R7.1, U1.1 (VCC), U2.5 (VCC)
GND: C1.2, C2.2, C3.2, C4.2, D1.1 (K), J1.6, J2.1, R1.2, U1.3 (GND), U2.2 (GND)
GND_humi1: J1.2, J2.3
GND_humi2: J1.3, J2.2
unnamed: C2.1, R2.2, U1.5 (DVI)
unnamed: D1.2 (A), R7.2
unnamed: JP1.2, R1.1, U1.2 (ADR)
SCL: J1.4, R3.2, R6.2, U1.6 (SCL), U2.6 (SCL)
SDA: J1.5, R4.2, R5.2, U1.4 (SDA), U2.1 (SDA)

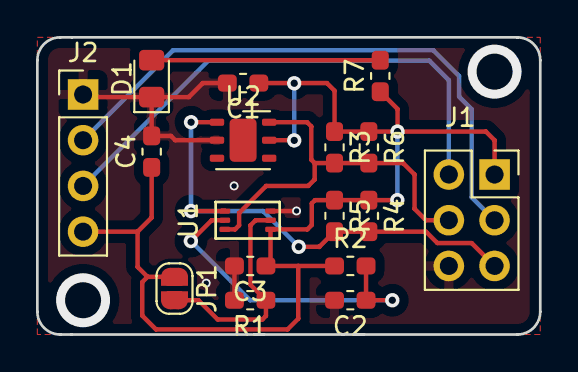
[picture p39: board Sensorplatine.kicad_pcb from above]

Board: 2 copper layers, 27.9 x 16.5 mm, 17 parts (0 on the bottom side), 9 nets.
