Oszimilian/SBIO/Software_Alt/SBIO_3/SBIO_3/Port_Funktion.c

#define F_CPU 16000000

#include <stdlib.h>																//Standard Library
//#include <math.h>																//Mathematische Funktionen
//#include <string.h>															//Stringfunktionen (Zeichenkettenfunkionen)
#include <avr/io.h>																//Input Output Funktioen
#include <avr/interrupt.h>														//Programmunterbrechungsfunktionen
//#include <avr/sleep.h>	 													//Stromsparfunktion
//#include <avr/power.h>														//?
//#include <avr/wdt.h>															//Watchdog-Timer (Schleifenfunktionen haben einen Timer)
#include <avr/pgmspace.h>														//?
#include <avr/eeprom.h>														//Zugriff auf das EEPROM
#include <util/delay.h>															//Zeitfunktionen
#include <stdint.h>
#include "All.h"

volatile uint8_t ShiftReg[16];

	
	
/******************************************************************************
*                                                                             *
*                                 OUTPUT-SET                                  *
*                                                                             *
******************************************************************************/
void Set_Pumpe (uint8_t Zustand, uint8_t PWM_Wert)
{
	if (Zustand == ON)
	{
		PORTA |= (1<<3);
	}
	if (Zustand == OFF)
	{
		PORTA &= ~(1<<3);
	}
	if (Zustand == PWM)
	{
		PWM_Pumpe = PWM_Wert;
	}
	
}

void Set_Heizung (uint8_t Zustand, uint8_t PWM_Wert)
{
	if (Zustand == ON)
	{
		PORTA |=  (1<<4);
		ShiftReg[Heizung] = ON;
	}
	if (Zustand == OFF)
	{
		PORTA &= ~(1<<4);
		ShiftReg[Heizung] = OFF;
	}
	if (Zustand == PWM)
	{
		_delay_ms(1);
	}
	
}

void Set_Lufter1 (uint8_t Zustand, uint8_t PWM_Wert)
{
	if (Zustand == ON)
	{
		PORTA |=  (1<<5);
	}
	if (Zustand == OFF)
	{
		PORTA &= ~(1<<5);
	}
	if (Zustand == PWM)
	{
		PWM_Lufter1 = PWM_Wert;
	}
	
}

void Set_Lufter2 (uint8_t Zustand, uint8_t PWM_Wert)
{
	if (Zustand == ON)
	{
		PORTA |=  (1<<6);
	}
	if (Zustand == OFF)
	{
		PORTA &= ~(1<<6);
	}
	if (Zustand == PWM)
	{
		PWM_Lufter2 = PWM_Wert;
	}
	
}

void Set_RGB1_ROT (uint8_t Zustand, uint8_t PWM_Wert)
{
	if (Zustand == ON)
	{
		PORTC |=  (1<<6);
	}
	if (Zustand == OFF)
	{
		PORTC &= ~(1<<6);
	}
	if (Zustand == PWM)
	{
		PWM_RGB1_Rot = PWM_Wert;
	}
	
}

void Set_RGB1_GRUEN (uint8_t Zustand, uint8_t PWM_Wert)
{
	if (Zustand == ON)
	{
		PORTC |=  (1<<5);
	}
	if (Zustand == OFF)
	{
		PORTC &= ~(1<<5);
	}
	if (Zustand == PWM)
	{
		PWM_RGB1_Gruen = PWM_Wert;
	}
	
}

void Set_RGB1_BLAU (uint8_t Zustand, uint8_t PWM_Wert)
{
	if (Zustand == ON)
	{
		PORTC |=  (1<<4);
	}
	if (Zustand == OFF)
	{
		PORTC &= ~(1<<4);
	}
	if (Zustand == PWM)
	{
		PWM_RGB1_Blau = PWM_Wert;
	}
	
}



void Set_RGB2_ROT (uint8_t Zustand, uint8_t PWM_Wert)
{
	if (Zustand == ON)
	{
		PORTA |=  (1<<7);
	}
	if (Zustand == OFF)
	{
		PORTA &= ~(1<<7);
	}
	if (Zustand == PWM)
	{
		PWM_RGB2_Rot = PWM_Wert;
	}
	
}

void Set_RGB2_GRUEN (uint8_t Zustand, uint8_t PWM_Wert)
{
	if (Zustand == ON)
	{
		PORTG |=  (1<<2);
	}
	if (Zustand == OFF)
	{
		PORTG &= ~(1<<2);
	}
	if (Zustand == PWM)
	{
		PWM_RGB2_Gruen = PWM_Wert;
	}
	
}

void Set_RGB2_BLAU (uint8_t Zustand, uint8_t PWM_Wert)
{
	if (Zustand == ON)
	{
		PORTC |=  (1<<7);
	}
	if (Zustand == OFF)
	{
		PORTC &= ~(1<<7);
	}
	if (Zustand == PWM)
	{
		PWM_RGB2_Blau = PWM_Wert;
	}
	
}

void Set_Dbg2 (uint8_t Zustand)
{
	switch (Zustand)
	{
		case ON:  PORTB |=  (1<<2); break;
		case OFF: PORTB &= ~(1<<2); break;
	}
}

void Set_SRLatch (uint8_t Zustand)
{
	switch (Zustand)
	{
		case ON:  PORTB |=  (1<<4); break;
		case OFF: PORTB &= ~(1<<4); break;
	}
}

void Set_SRDaten (uint8_t Zustand)
{
	switch (Zustand)
	{
		case ON:  PORTB |=  (1<<5); break;
		case OFF: PORTB &= ~(1<<5); break;
	}
}

void Set_SRTakt (uint8_t Zustand)
{
	switch (Zustand)
	{
		case ON:  PORTB |=  (1<<6); break;
		case OFF: PORTB &= ~(1<<6); break;
	}
}
void Set_SM1_1 (uint8_t Zustand)
{
	switch (Zustand)
	{
		case ON:  PORTD |=  (1<<6); break;
		case OFF: PORTD &= ~(1<<6); break;
	}
}

void Set_SM1_2 (uint8_t Zustand)
{
	switch (Zustand)
	{
		case ON:  PORTD |=  (1<<7); break;
		case OFF: PORTD &= ~(1<<7); break;
	}
}

void Set_SM1_3 (uint8_t Zustand)
{
	switch (Zustand)
	{
		case ON:  PORTG |=  (1<<0); break;
		case OFF: PORTG &= ~(1<<0); break;
	}
}

void Set_SM1_4 (uint8_t Zustand)
{
	switch (Zustand)
	{
		case ON:  PORTG |=  (1<<1); break;
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
	return ADCWert;	
}

uint16_t Get_GND_Humi2()
{
	uint8_t ADCWert;
	ADCWert = ADC_Messung(1);
}

uint16_t Get_Voltage()
{
	uint16_t ADCWert;
	ADCWert = ADC_Messung(2);
	return ADCWert;
}

uint16_t Get_Current()
{
	uint16_t ADCWert;
	ADCWert = ADC_Messung(3);
	return ADCWert;
}
